danielgomezobraztsov/tfg-fall_detection_device/custom_pcb/pcb.png

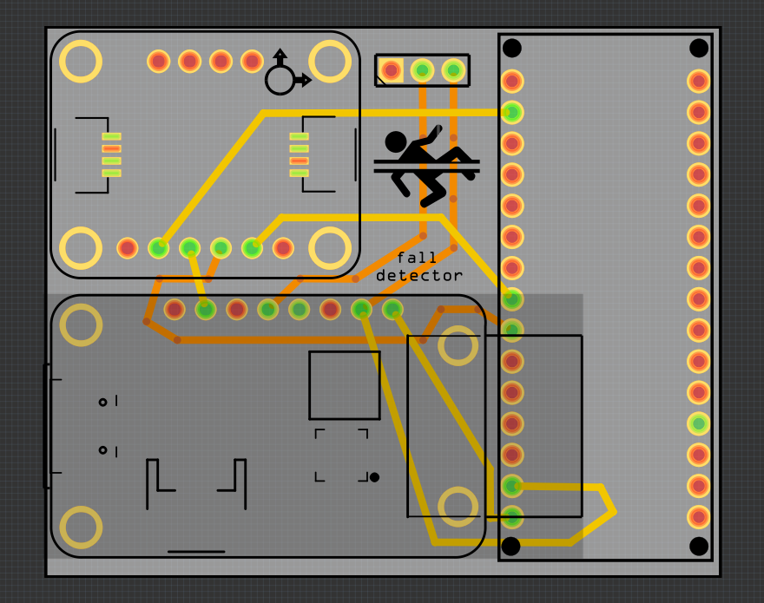
custom_pcb/pcb.png
