danielgomezobraztsov/tfg-fall_detection_device/box_model/box1/caja_externa-v3.2.3mf

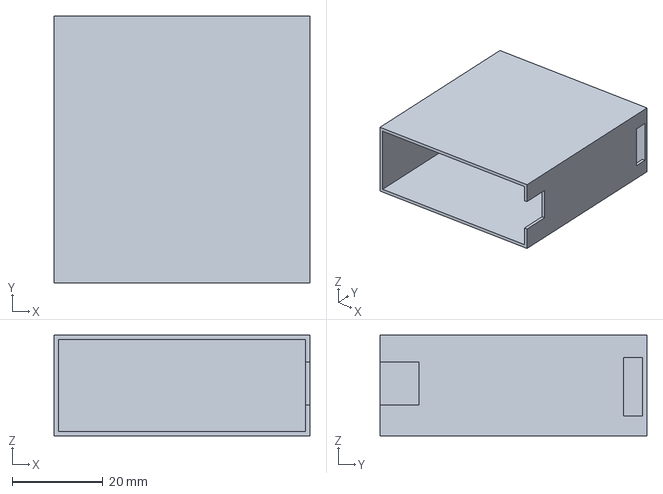
[picture p40: CAD file, 2026-05-10]
box_model/box1/caja_externa-v3.2.3mf
56.5 x 59.0 x 22.3 mm
