danielgomezobraztsov/tfg-fall_detection_device/box_model/box2/caja2_ext.3mf

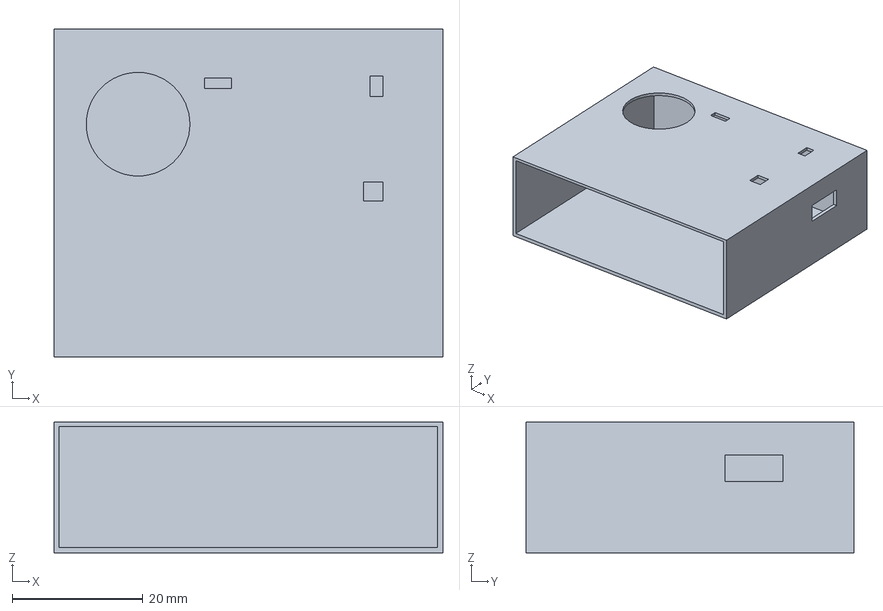
[picture p41: CAD file, 2026-06-23]
box_model/box2/caja2_ext.3mf
59.6 x 50.2 x 20.0 mm
