danielgomezobraztsov/tfg-fall_detection_device/box_model/failed attempts/caja_arduino_v3_arreglo1.3mf

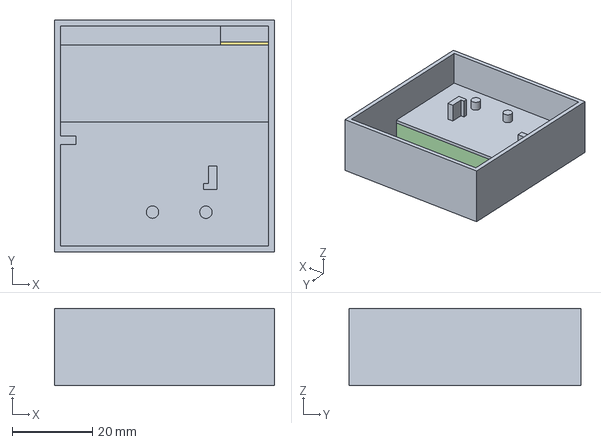
[picture p42: CAD file, 2026-05-10]
box_model/failed attempts/caja_arduino_v3_arreglo1.3mf
55.0 x 58.0 x 19.3 mm
