danielgomezobraztsov/tfg-fall_detection_device/box_model/box1/caja_arduino_v3-1.3mf-BodyPocket009.3mf

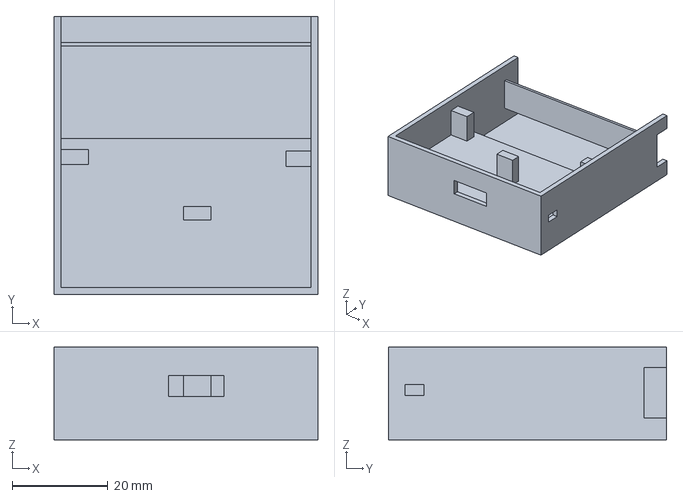
[picture p43: CAD file, 2026-05-10]
box_model/box1/caja_arduino_v3-1.3mf-BodyPocket009.3mf
55.0 x 58.0 x 19.3 mm
