danielgomezobraztsov/tfg-fall_detection_device/box_model/box2/caja2_arduino_v4.3mf

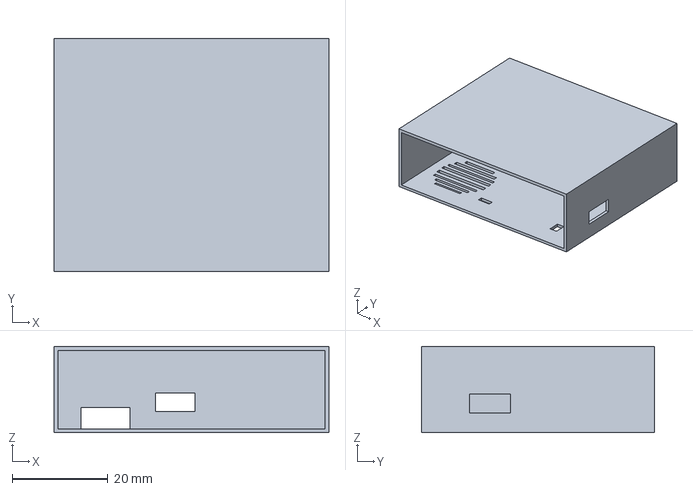
[picture p44: CAD file, 2026-06-23]
box_model/box2/caja2_arduino_v4.3mf
57.4 x 48.5 x 18.0 mm
