danielgomezobraztsov/tfg-fall_detection_device/box_model/failed attempts/caja_arduino_v3.3mf.3mf

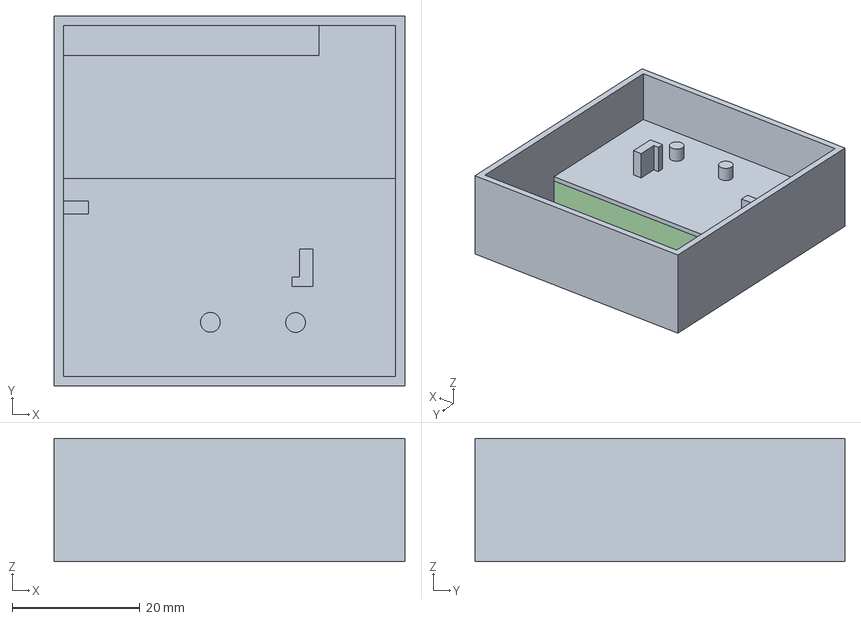
[picture p46: CAD file, 2026-05-10]
box_model/failed attempts/caja_arduino_v3.3mf.3mf
55.0 x 58.0 x 19.3 mm
