danielgomezobraztsov/tfg-fall_detection_device/box_model/failed attempts/caja_arduino_v2.3mf

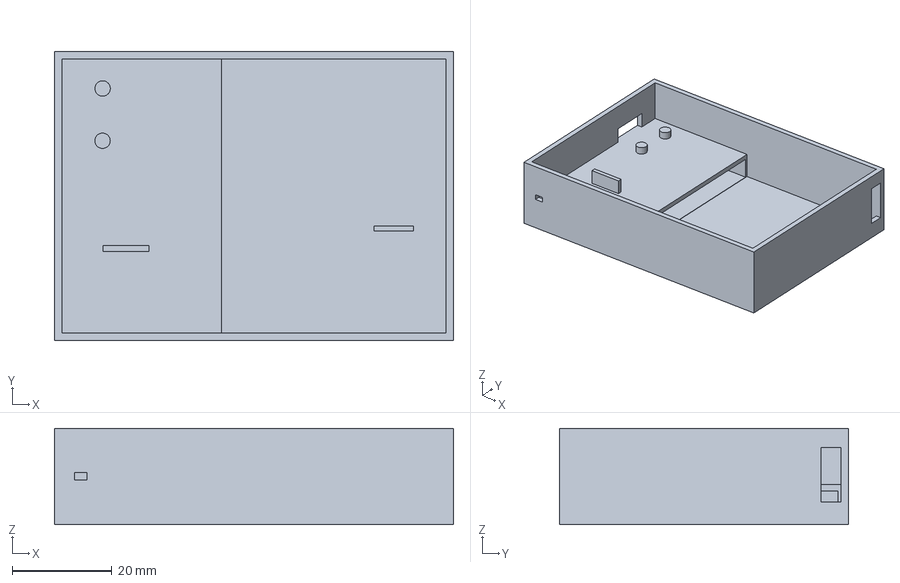
[picture p47: CAD file, 2026-05-10]
box_model/failed attempts/caja_arduino_v2.3mf
80.0 x 58.0 x 19.3 mm
