danielgomezobraztsov/tfg-fall_detection_device/box_model/failed attempts/caja_arduino_v0.3mf.FCStd

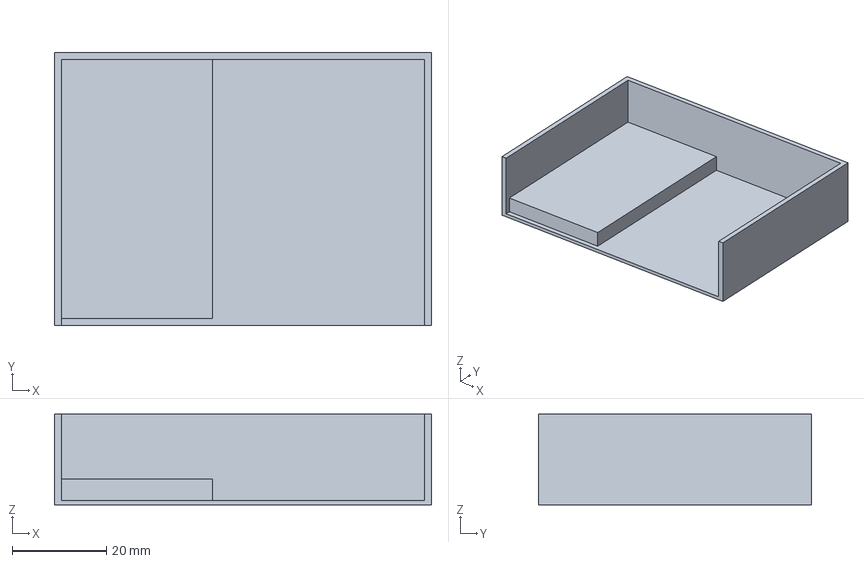
[picture p50: CAD file, 2026-05-10, an earlier design]
box_model/failed attempts/caja_arduino_v0.3mf.FCStd
80.0 x 58.0 x 19.3 mm
