danielgomezobraztsov/tfg-fall_detection_device/box_model/failed attempts/caja_arduino_v1.3mf

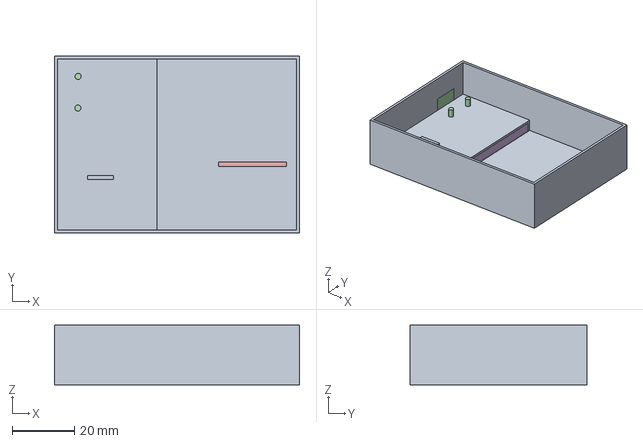
[picture p51: CAD file, 2026-05-10, an earlier design]
box_model/failed attempts/caja_arduino_v1.3mf
79.0 x 57.0 x 19.3 mm
