danielgomezobraztsov/tfg-fall_detection_device/box_model/failed attempts/caja_externa-v3.3mf

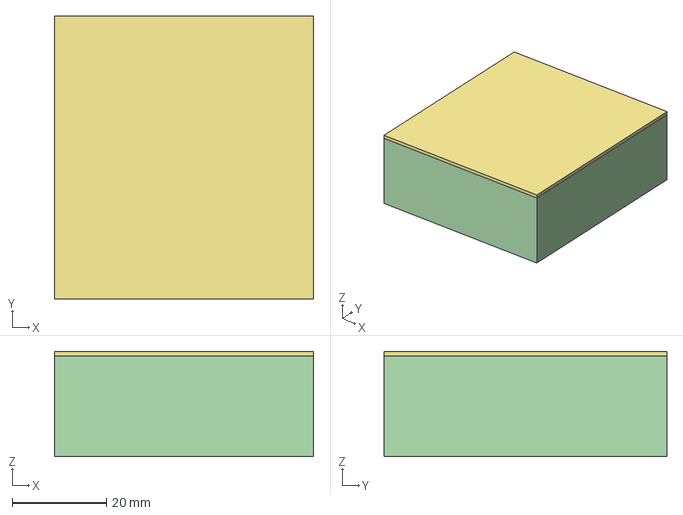
[picture p52: CAD file, 2026-05-10, an earlier design]
box_model/failed attempts/caja_externa-v3.3mf
55.0 x 60.0 x 22.3 mm
