danielgomezobraztsov/tfg-fall_detection_device/(list of files, cad)

Other CAD files:
box_model/failed attempts/caja_externa-v3_arreglo1_pocket.3mf
box_model/failed attempts/caja_arduino_v3.3mf-BodyPocket005.3mf
box_model/failed attempts/caja_arduino_v2.3mf.FCStd
