danielgomezobraztsov/tfg-fall_detection_device/custom_pcb/exportacion pcb/diagram_circuit_tfg_v2_etch_copper_bottom_mirror.pdf

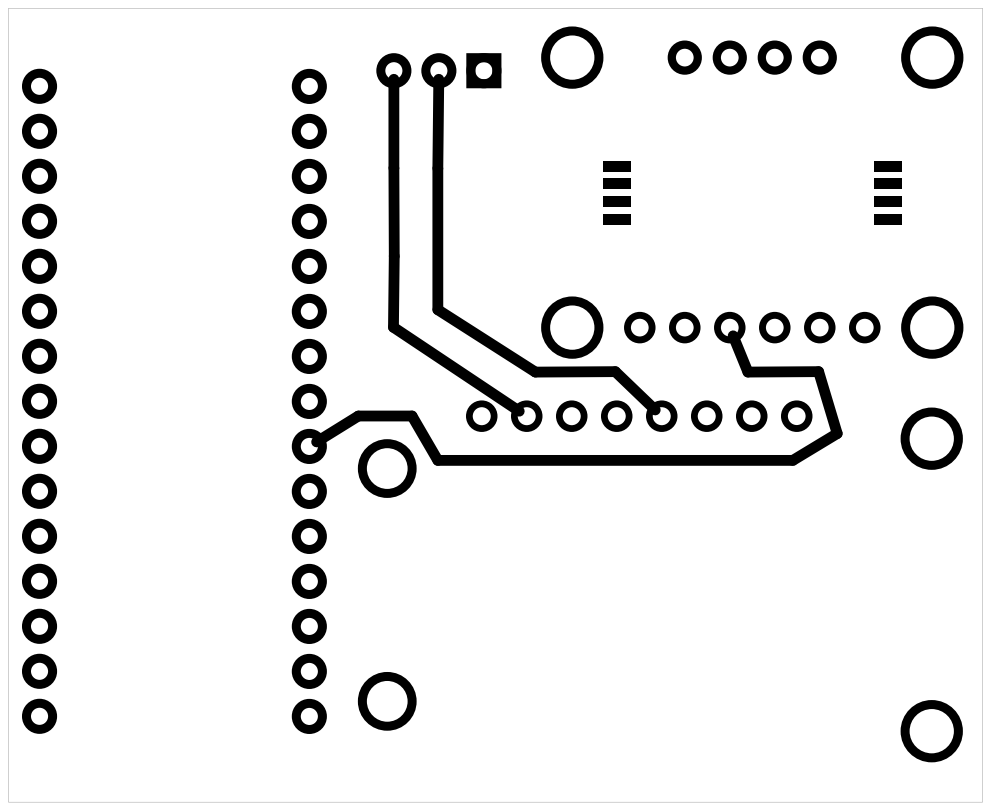
[picture p54: page 1]
