danielgomezobraztsov/tfg-fall_detection_device/custom_pcb/exportacion pcb/diagram_circuit_tfg_v2_etch_mask_bottom.pdf

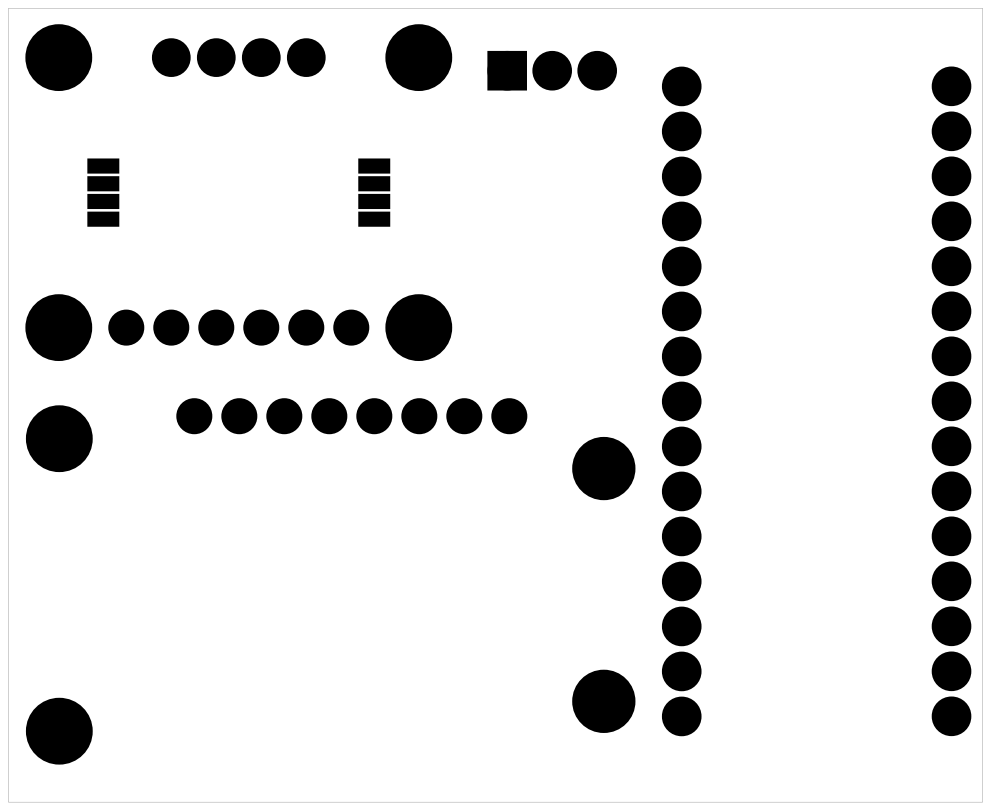
[picture p57: page 1]
