danielgomezobraztsov/tfg-fall_detection_device/custom_pcb/exportacion pcb/diagram_circuit_tfg_v2_etch_mask_bottom_mirror.pdf

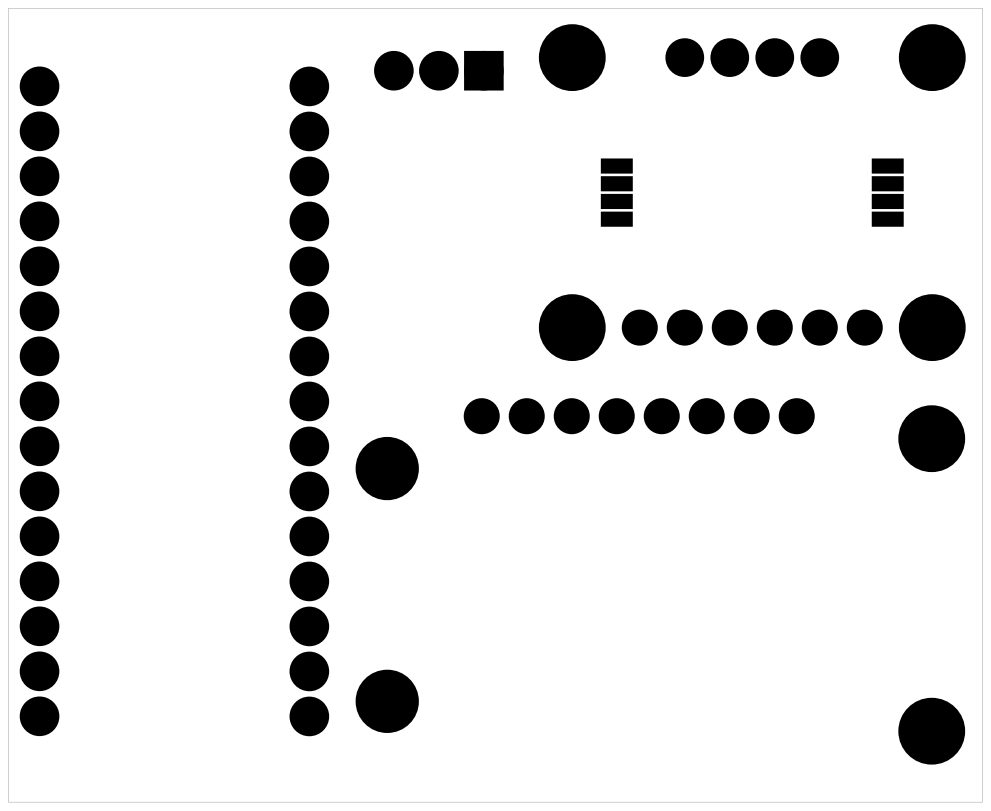
[picture p58: page 1]
