danielgomezobraztsov/tfg-fall_detection_device/custom_pcb/exportacion pcb/diagram_circuit_tfg_v2_etch_silk_top_mirror.pdf

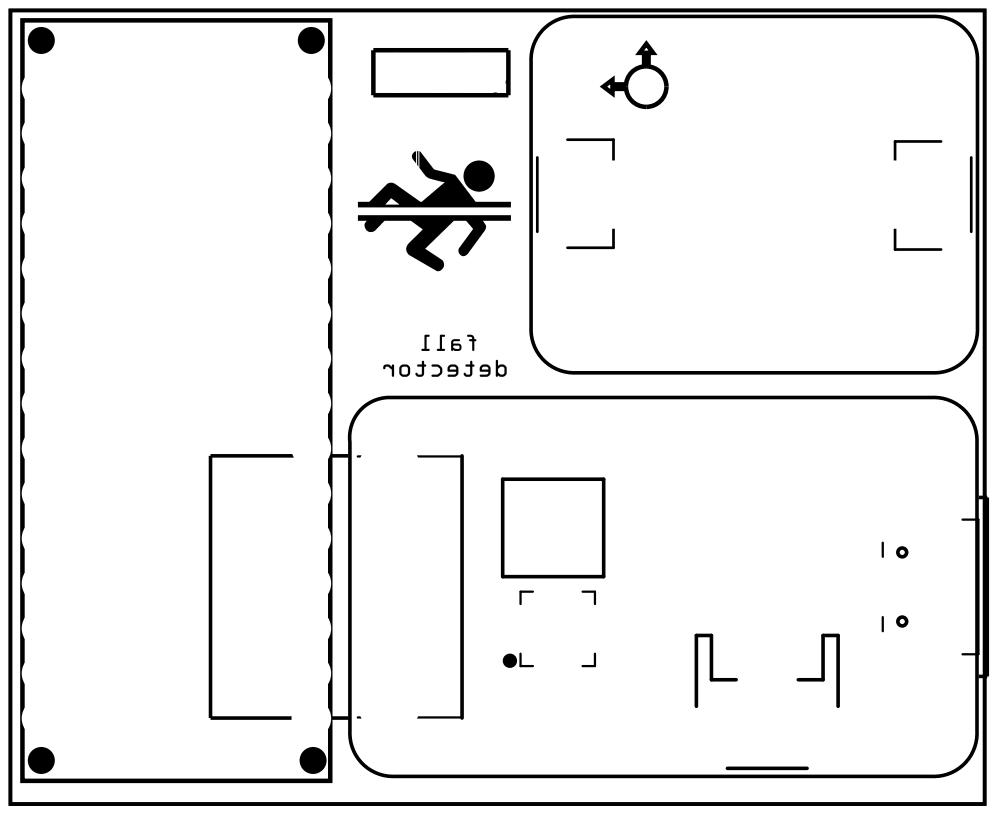
[picture p61: page 1]
