danielgomezobraztsov/tfg-fall_detection_device/(list of files, drawings)

Other design files:
custom_pcb/diagram_circuit_tfg_v2.fzz
