danielgomezobraztsov/tfg-fall_detection_device/test_code/initial_test.ino

#include <Wire.h>
#include <Adafruit_Sensor.h>
#include <Adafruit_BNO055.h>
#include <utility/imumaths.h>

// Codigo de ejemplo de Adafruit para el sensor BNO055: https://learn.adafruit.com/adafruit-bno055-absolute-orientation-sensor/arduino-code
  
Adafruit_BNO055 bno = Adafruit_BNO055(55);

void setup(void) 
{
  Serial.begin(9600);
  Serial.println("Orientation Sensor Test"); Serial.println("");
  
  /* Initialise the sensor */
  if(!bno.begin())
  {
    /* There was a problem detecting the BNO055 ... check your connections */
    Serial.print("Ooops, no BNO055 detected ... Check your wiring or I2C ADDR!");
    while(1);
  }
  
  delay(1000);
    
  bno.setExtCrystalUse(true);
}

void loop(void) 
{
  /* Get a new sensor event */ 
  sensors_event_t event; 
  bno.getEvent(&event);
  
  /* Display the floating point data */
  Serial.print("X: ");
  Serial.print(event.orientation.x, 4);
  Serial.print("\tY: ");
  Serial.print(event.orientation.y, 4);
  Serial.print("\tZ: ");
  Serial.print(event.orientation.z, 4);
  Serial.println("");
  
  delay(100);
}
