danielgomezobraztsov/tfg-fall_detection_device/(commit log)

2025-12-03 4 ejemplo de codigo para testeo del sensor
2025-12-03 version del word en markdown para mantenerlo actualizado en el repositorio
2026-02-25 circuito de alimentacion y carga
2026-02-26 explicacion de conn qwiic
2026-02-26 arreglo de formato
2026-03-11 version using the gyroscope as well
2026-03-12 comienzo de la explicacion del agoritmo
2026-03-12 apuntes para seguir mas adelante
2026-04-04 avances en la explicacion del algoritmo
2026-04-13 avance en apuntes (info del algoritmo + primeros pasos de ML)
2026-04-13 arreglo de formato de ecuacion
2026-04-24 la app movil que no la habia subido
2026-04-27 metido tema de permisos para poder hacer llamadas y enviar SMS a los contactos. Pero aun no se puede editar un contacto y hay unos cuantos problemas :/
2026-04-27 version del firmware con modo hotspot para la conn, pero aun me da problemas la app hahah me estoy volviendo loco
    [hotspot.ino]
2026-04-27 version con guardado de datos en un txt para poder analizarlo luego
2026-05-10 inner and outer box 3d models
    [caja_arduino_v0.3mf.FCStd, caja_arduino_v1.3mf, caja_arduino_v2.3mf, caja_arduino_v2.3mf.FCStd, caja_arduino_v3-1.3mf-BodyPocket009.3mf, caja_arduino_v3.3mf-BodyPocket005.3mf, caja_arduino_v3.3mf.3mf, caja_arduino_v3_arreglo1.3mf]
2026-05-10 refactor muy grande + ahora hace bien las llamadas y funciona en segundo plano. falta: que se reproduzca un audio durante la llamada, que vibre y pite el movil durante una caida y muchas cosas de QoL
2026-05-16 version con persistencia para el modulo de boosteo de voltage, para que no se apague
2026-05-16 version del algoritmo con cambio en logica de deteccion de posicion, ahora usa vector GRAVITY en vez de EULER, parece dar mejores resultados
2026-05-16 metido logica de envio de ubi/localizacion en el sms, hay que pulirlo que hay problemillas
2026-05-20 funcionamiento con mDNS para que la ip no tenga que estar hardcoded
2026-05-23 guardado de datos del arduino para poder estudiarlos (y a lo mejor usarlo para entranar modelo de ai, si es que lo hago)
2026-05-23 boton para exportar los archivos con los datos del arduino
2026-05-25 update para poder almacenar mas de un ssid y passwd + que la conn cicle probandolas (para el uso fuera de casa)
2026-05-25 ahora se pueden enviar los creds de la red de casa y la del hotspot movil a la vez (no testeado todavia)
2026-05-25 arreglo de sintaxis, duplicacion accidental
    [final_version.ino]
2026-06-05 first attempt at custom pcb design...maybe final attempt? (it is actually my second)
    [diagram_circuit_tfg_v2.fzz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]
2026-06-23 ultimos modelos de las cajas
    [caja2_arduino_v4.3mf, caja2_ext.3mf, caja_arduino_v3-1.3mf-BodyPocket009.3mf, caja_externa-v3.2.3mf]
2026-06-23 version con logica de postura actualizada, tiene mas de 2 semanas, no lo subi
2026-06-23 borrado de caca y restructurado un poco las carpetas
2026-06-24 arreglo de consistencia en name para que sea igual load() que save()
